marhmm/mi_robot_mods/autocontrol/config_template.h

#define PIN_MOS                   5

#define AUTO_START_DELAY          60
#define AUTO_SHUTDOWN_DELAY       20

const char* host = "esp8266-autocontrol";
const char* ssid = "xxxxx";
const char* password = "yyyyy";

const String valetudo_url = "http://x.x.x.x";
